WorldWilderLab/Planet/kicad/Vocab.pdf

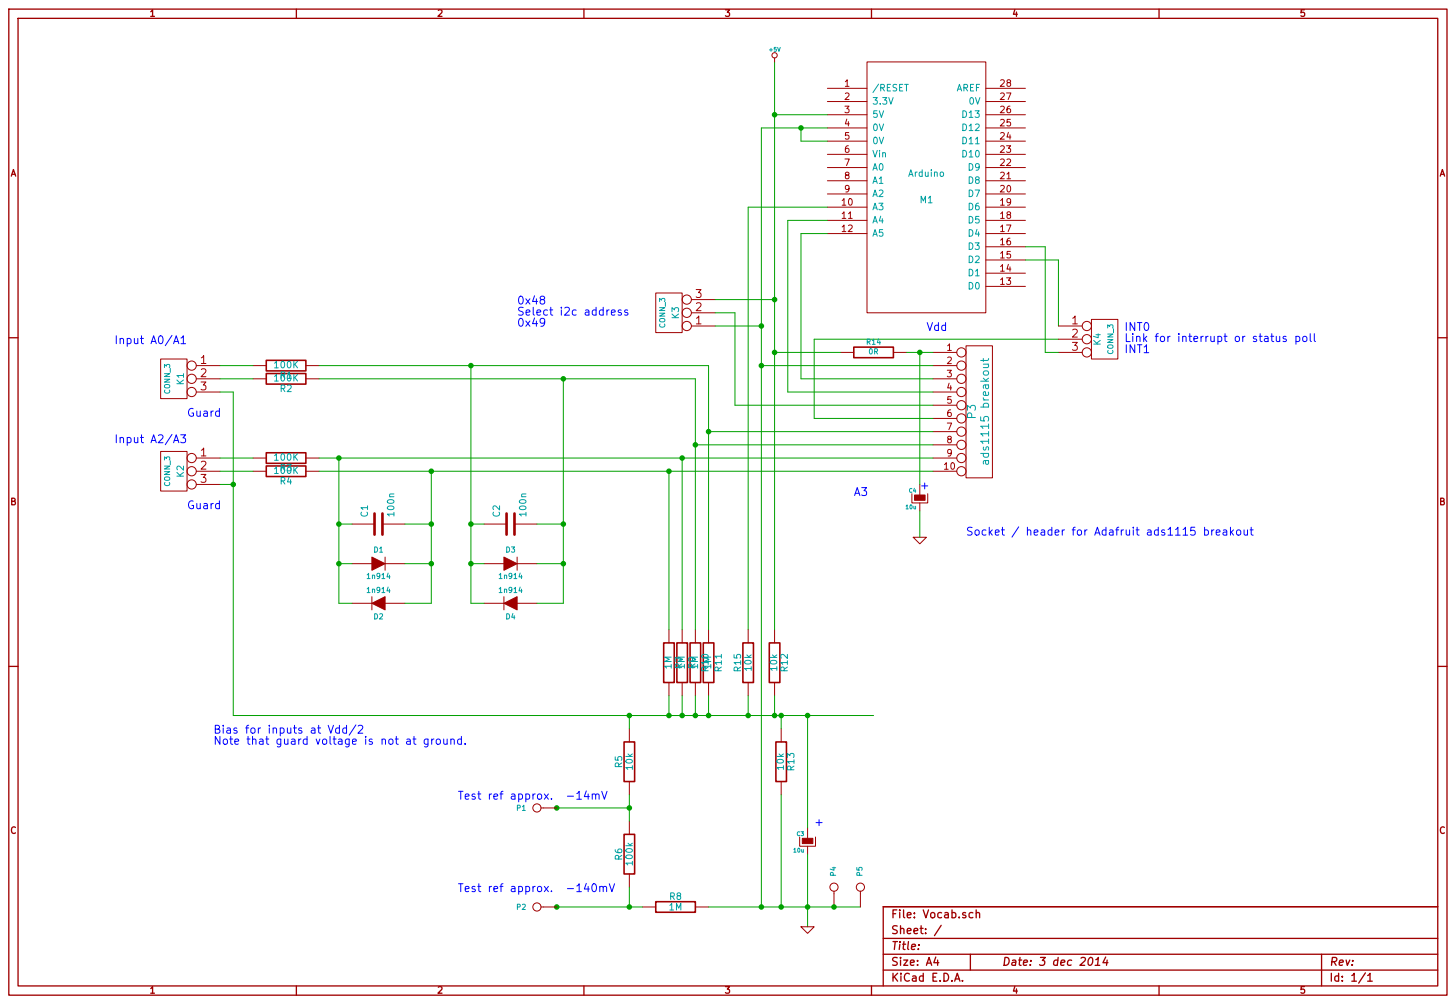
[picture p1: page 1]

INT0
Link for interrupt or status poll INT1

Socket / header for Adafruit ads1115 breakout

Note that guard voltage is not at ground.

Id: 1/1 Title: File: Vocab.sch Sheet: /
