WorldWilderLab/Planet/kicad/Vocab.kicad_pcb

## KiCad design kicad/Vocab.kicad_pcb (2015-02-18)

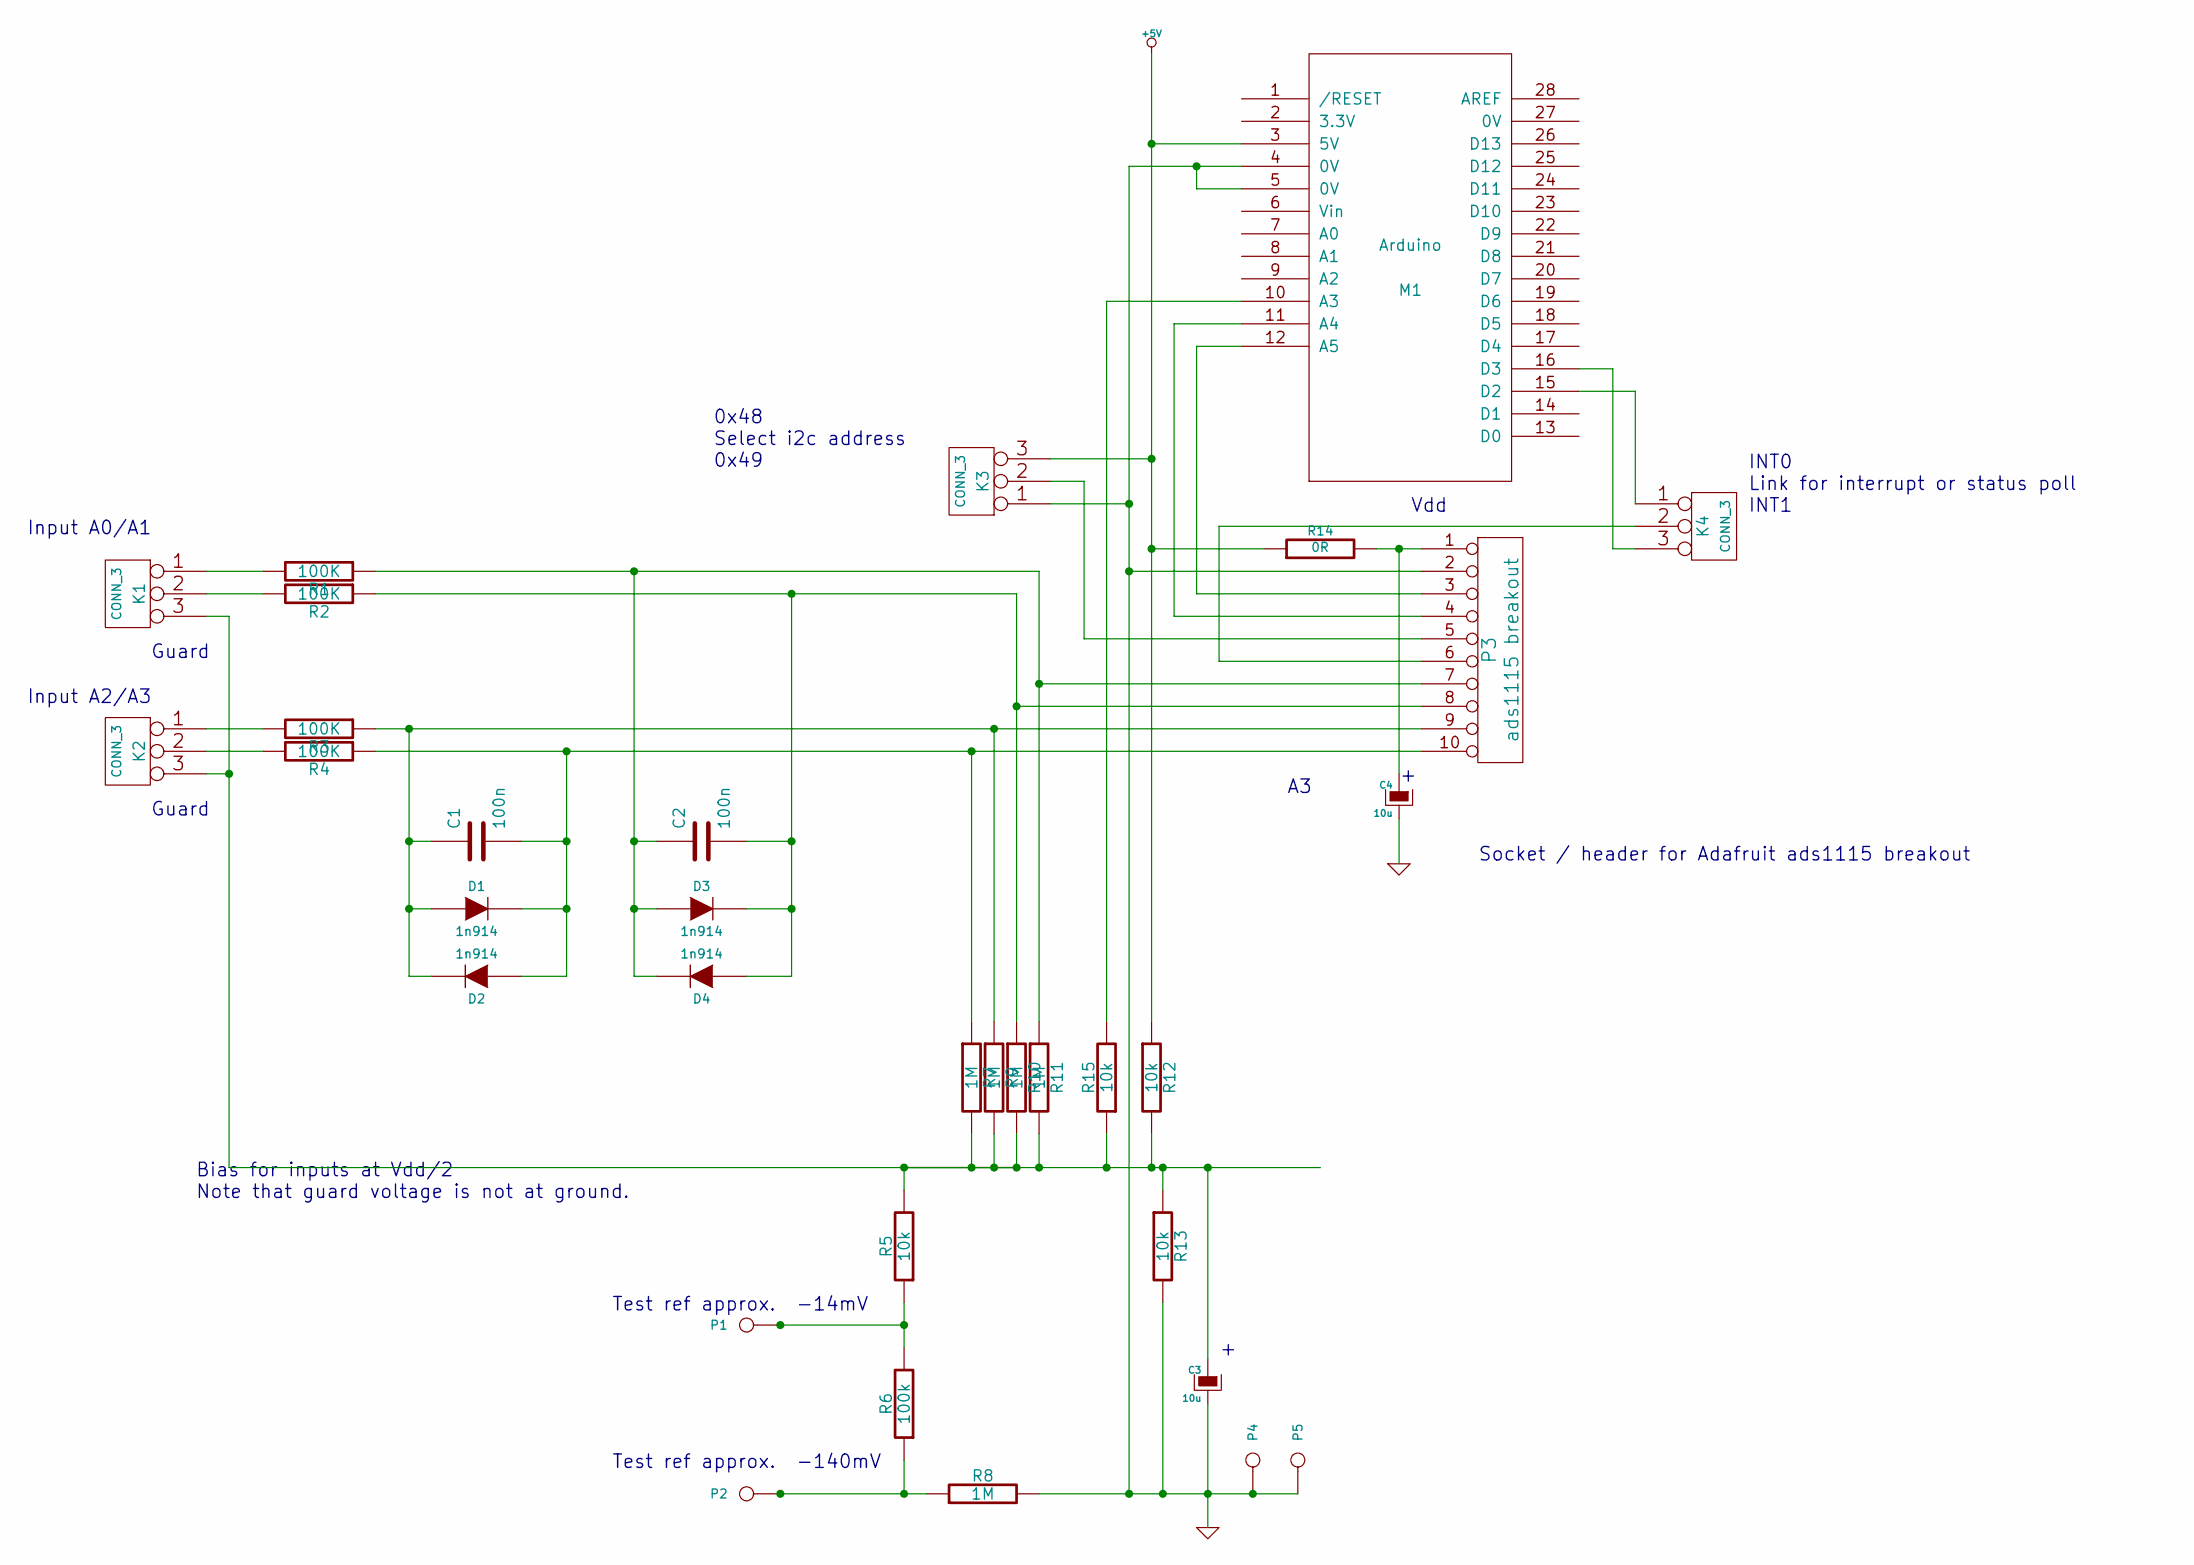
[picture p2: schematic Vocab.sch]

Parts:
C1, C2: 100n
C3, C4: 10u
D1, D2, D3, D4: 1n914
K1, K2, K3, K4: CONN_3
M1: Arduino; MODULE
P1, P2, P4, P5: CONN_1
P3: ads1115 breakout
R1, R2, R3, R4: 100K
R5, R12, R13, R15: 10k
R6: 100k
R7, R8, R9, R10, R11: 1M
R14: 0R

Connections:
+5V: K3.3, M1.3 (5V), R12.1, R14.1
GND: C3.2, C4.2, K3.1, M1.4 (0V), M1.5 (0V), P3.2, P4.1, P5.1, R8.2, R13.2
unnamed: C2.1, D3.1 (A), D4.2 (K), P3.7, R1.1, R11.1
unnamed: M1.12 (A5), P3.3
unnamed: M1.11 (A4), P3.4
unnamed: C4.1, P3.1, R14.2
unnamed: M1.10 (A3), R15.2
unnamed: K4.2 (PM), P3.6
unnamed: P2.1, R6.1, R8.1
unnamed: P1.1, R5.1, R6.2
unnamed: K4.1, M1.15 (D2)
unnamed: K4.3, M1.16 (D3)
unnamed: K3.2 (PM), P3.5
unnamed: C2.2, D3.2 (K), D4.1 (A), P3.8, R2.1, R10.1
unnamed: K1.1, R1.2
unnamed: K1.2 (PM), R2.2
unnamed: K2.1, R3.2
unnamed: K2.2 (PM), R4.2
unnamed: C3.1, K1.3, K2.3, R5.2, R7.2, R9.2, R10.2, R11.2, R12.2, R13.1, R15.1
unnamed: C1.1, D1.1 (A), D2.2 (K), P3.9, R3.1, R9.1
unnamed: C1.2, D1.2 (K), D2.1 (A), P3.10, R4.1, R7.1

Notes on the sheet:
Test ref approx. -140mV
Guard
Vdd
Bias for inputs at Vdd/2 Note that guard voltage is not at ground.
Input A0/A1
Input A2/A3
Socket / header for Adafruit ads1115 breakout
Test ref approx. -14mV
INT0 Link for interrupt or status poll INT1
0x48 Select i2c address 0x49

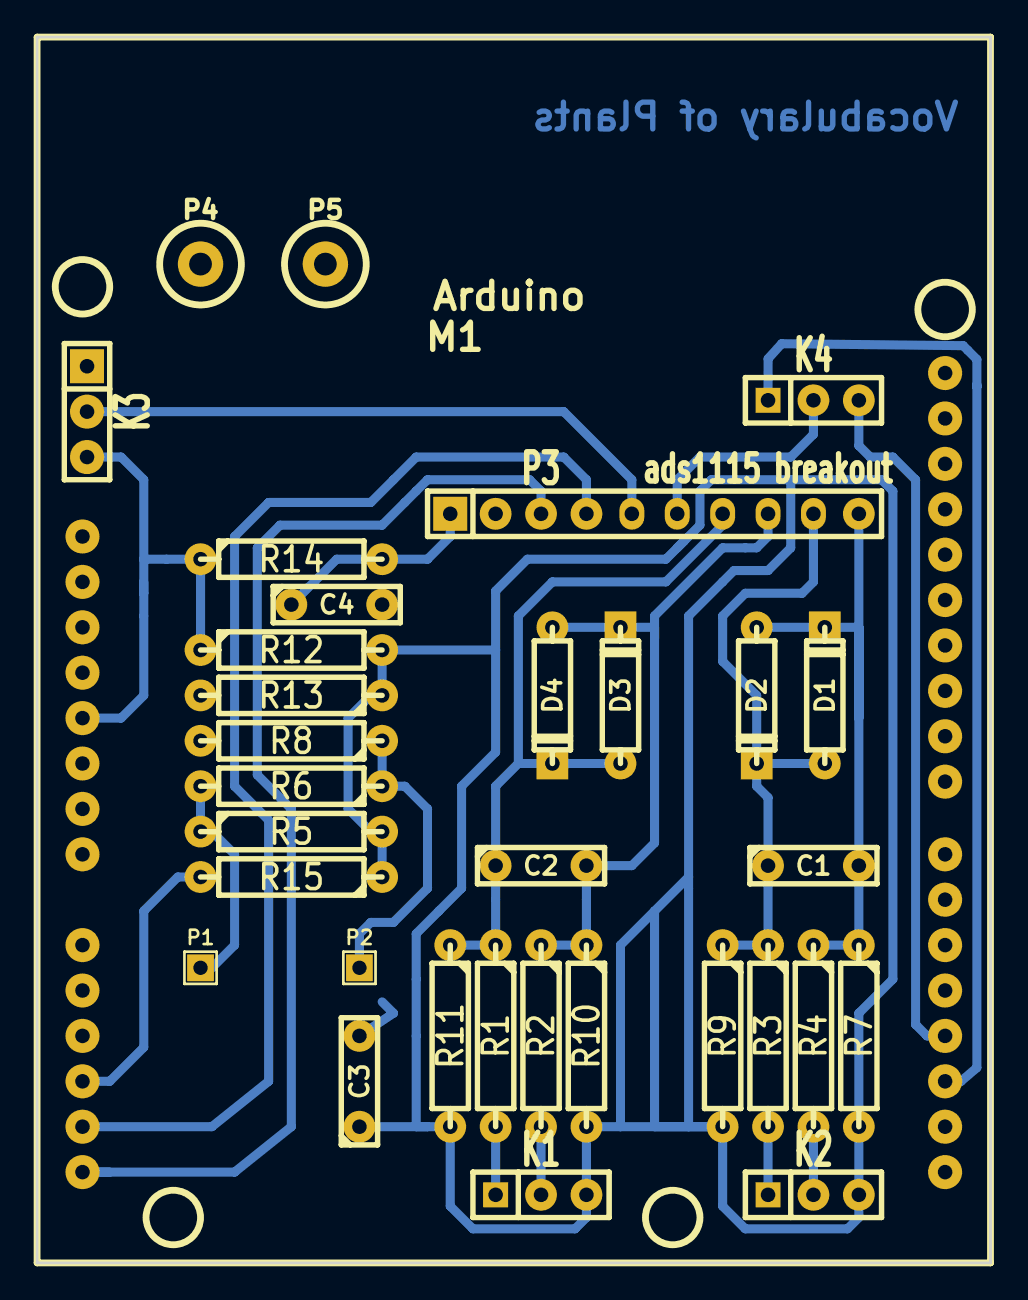
[picture p3: board Vocab.kicad_pcb from above]

Board: 2 copper layers, 53.3 x 68.6 mm, 33 parts (0 on the bottom side), 21 nets.
