WorldWilderLab/Planet/(threads)

Thread 3 (2015-02-18):

Probe connectors incorrect

artag, 2015-02-18:
The probe connectors will fit on the 0.1" molex headers but are spaced too tightly to allow both to be connected. They're also held in place by the locking ramp rather than the connection spring. A connector is required that will :

Fit the probe sockets correctly (2mm dia)
Space the probe connectors at least 7mm apart
Allow for a ground connection

Thread 21 (2015-04-19):

probe 0 is not being reported

lifthoofd, 2015-04-19:
it could be caused by this from line 92 from `kicad/vocab_mqtt.ino`
`plist[] = {`
here should most likely be a `{NULL}` entry too (at `plist[0]`)
`//  { "/light",   { 0 }, { 0 }, 0,500, 5000,  VFLOAT  },
  { "/probe/0",  { 0 }, { 0 }, 0,500, 5000,  VFLOAT  },
  { "/probe/1",  { 0 }, { 0 }, 0,500, 5000,  VFLOAT  },
//  { "/debug/loopt", { 0 }, { 0 },0,2000,25000, VINT    },
  { NULL }
};`

lifthoofd, 2015-04-20:
solved by commenting an entry to the enum on line 100:
`enum PUBLISHIX { /*PLIGHT,*/ PPROBE0, PPROBE1, PLOOPT  };`

Closed 2015-04-20.

Thread 25 (2015-07-14):

save broker ip address permanently in arduino memory

lifthoofd, 2015-07-14:
