WorldWilderLab/Planet/(commit log)

2015-03-22 Removed light sensor from output
2015-04-16 added bill of materials
    in csv format
    [Vocab-extended-BOM.csv]
2015-04-19 update parts list
    [Vocab-extended-BOM.csv]
2015-04-19 renamed BOM to partslist.csv
    [partslist.csv]
2015-04-19 updated partslist
    [partslist.csv]
2015-04-20 Fixed probe 0 not reporting
    [vocab_mqtt.ino]
2015-06-05 Increased time precision to milliseconds for log
